IUNO-TDM/MotorShield/MotorShield.brd

## EAGLE design MotorShield.brd (2018-02-16)

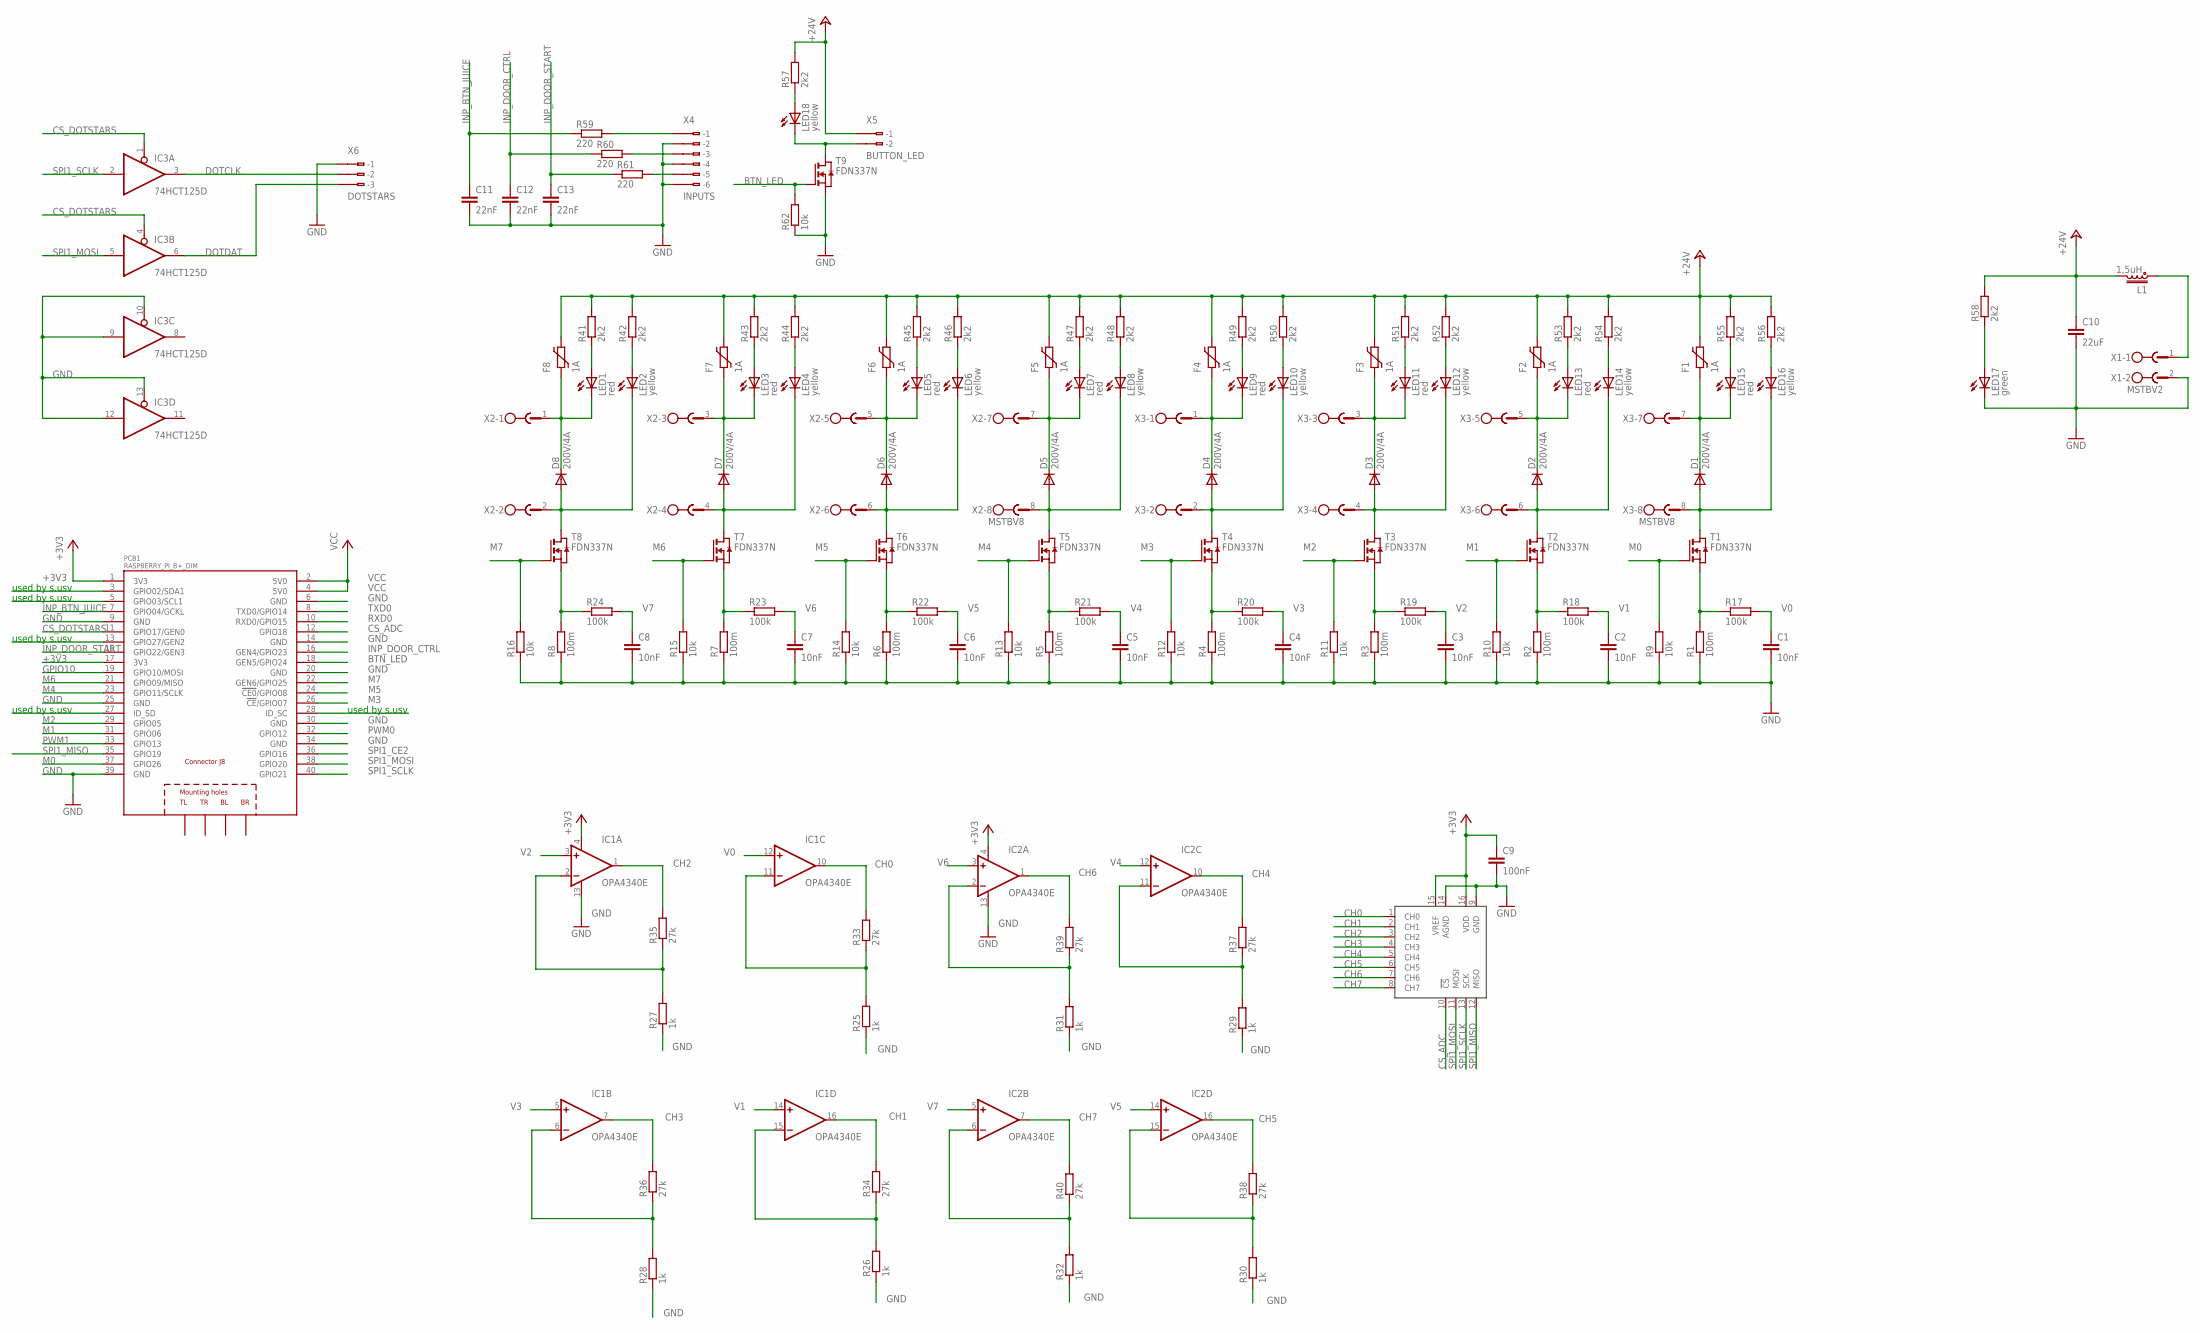
[picture p1: schematic MotorShield.sch]

Parts:
C1, C2, C3, C4, C5, C6, C7, C8: 10nF; C0805
C9: 100nF; C0805
C10: 22uF; C1812
C11, C12, C13: 22nF; C0805K
D1, D2, D3, D4, D5, D6, D7, D8: 200V/4A; DO214AA
F1, F2, F3, F4, F5, F6, F7, F8: 1A; 1812L
IC1, IC2: OPA4340E; SSOP16BU
IC3: 74HCT125D; SO14
IC4: MCP3008SL; SO16
L1: 1,5uH; MPI4040
LED1, LED3, LED5, LED7, LED9, LED11, LED13, LED15: red; CHIP-LED0805
LED2, LED4, LED6, LED8, LED10, LED12, LED14, LED16, LED18: yellow; CHIP-LED0805
LED17: green; CHIP-LED0805
PCB1: RASPBERRY_PI_B+_DIM; RASPBERRY_PI_BPLUS_DIM
R1, R2, R3, R4, R5, R6, R7, R8: 100m; R0805
R9, R10, R11, R12, R13, R14, R15, R16, R62: 10k; R0805
R17, R18, R19, R20, R21, R22, R23, R24: 100k; R0805
R25, R26, R27, R28, R29, R30, R31, R32: 1k; R0805
R33, R34, R35, R36, R37, R38, R39, R40: 27k; R0805
R41, R42, R43, R44, R45, R46, R47, R48, R49, R50, R51, R52, R53, R54, R55, R56, R57, R58: 2k2; R0805
R59, R60, R61: 220; R0805
T1, T2, T3, T4, T5, T6, T7, T8, T9: FDN337N; SOT-23
X1: MSTBV2
X2, X3: MSTBV8
X4: INPUTS; 233-506
X5: BUTTON_LED; 233-502
X6: DOTSTARS; 233-503

Connections:
+3V3: C9.1, IC1.4 (V+), IC2.4 (V+), IC4.15 (VREF), IC4.16 (VDD), PCB1.1 (3V3), PCB1.17 (3V3)
+24V: C10.1, F1.2, F2.2, F3.2, F4.2, F5.2, F6.2, F7.2, F8.2, L1.2, R41.2, R42.2, R43.2, R44.2, R45.2, R46.2, R47.2, R48.2, R49.2, R50.2, R51.2, R52.2, R53.2, R54.2, R55.2, R56.2, R57.2, R58.2, X5.B1 (B-1)
BTN_LED: PCB1.18 (GEN5/GPIO24), R62.2, T9.3 (G)
CH0: IC1.10 (OUT), IC4.1 (CH0), R33.2
CH1: IC1.16 (OUT), IC4.2 (CH1), R34.2
CH2: IC1.1 (OUT), IC4.3 (CH2), R35.2
CH3: IC1.7 (OUT), IC4.4 (CH3), R36.2
CH4: IC2.10 (OUT), IC4.5 (CH4), R37.2
CH5: IC2.16 (OUT), IC4.6 (CH5), R38.2
CH6: IC2.1 (OUT), IC4.7 (CH6), R39.2
CH7: IC2.7 (OUT), IC4.8 (CH7), R40.2
CS_ADC: IC4.10 (!CS), PCB1.12 (GPIO18)
CS_DOTSTARS: IC3.1 (OE), IC3.4 (OE), PCB1.11 (GPIO17/GEN0)
D8: D8.C, F8.1, LED1.C, X2.1
DOTCLK: IC3.3 (O), X6.B2 (B-2)
DOTDAT: IC3.6 (O), X6.B3 (B-3)
GND: C1.2, C2.2, C3.2, C4.2, C5.2, C6.2, C7.2, C8.2, C9.2, C10.2, C11.2, C12.2, C13.2, IC1.13 (V-), IC2.13 (V-), IC3.7 (GND), IC3.9 (I), IC3.10 (OE), IC3.12 (I), IC3.13 (OE), IC4.9 (GND), IC4.14 (AGND), LED17.C, PCB1.6 (GND), PCB1.9 (GND), PCB1.14 (GND), PCB1.20 (GND), PCB1.25 (GND), PCB1.30 (GND), PCB1.34 (GND), PCB1.39 (GND), R1.1, R2.1, R3.1, R4.1, R5.1, R6.1, R7.1, R8.1, R9.1, R10.1, R11.1, R12.1, R13.1, R14.1, R15.1, R16.1, R25.1, R26.1, R27.1, R28.1, R29.1, R30.1, R31.1, R32.1, R62.1, T9.2 (S), X1.2, X4.B2 (B-2), X4.B4 (B-4), X4.B6 (B-6), X6.B1 (B-1)
GPIO10: PCB1.19 (GPIO10/MOSI)
GPIO27: PCB1.13 (GPIO27/GEN2)
INP_BTN_JUICE: C11.1, PCB1.7 (GPIO04/GCKL), R59.1
INP_DOOR_CTRL: C12.1, PCB1.16 (GEN4/GPIO23), R60.1
INP_DOOR_START: C13.1, PCB1.15 (GPIO22/GEN3), R61.1
M0: PCB1.37 (GPIO26), R9.2, T1.3 (G)
M1: PCB1.31 (GPIO06), R10.2, T2.3 (G)
M2: PCB1.29 (GPIO05), R11.2, T3.3 (G)
M3: PCB1.26 (!CE!/GPIO07), R12.2, T4.3 (G)
M4: PCB1.23 (GPIO11/SCLK), R13.2, T5.3 (G)
M5: PCB1.24 (!CE0!/GPIO08), R14.2, T6.3 (G)
M6: PCB1.21 (GPIO09/MISO), R15.2, T7.3 (G)
M7: PCB1.22 (GEN6/GPIO25), R16.2, T8.3 (G)
unnamed: D8.A, LED2.C, T8.1 (D), X2.2
unnamed: R8.2, R24.1, T8.2 (S)
unnamed: D1.C, F1.1, LED15.C, X3.7
unnamed: D2.C, F2.1, LED13.C, X3.5
unnamed: IC1.2 (-IN), R27.2, R35.1
unnamed: D3.C, F3.1, LED11.C, X3.3
unnamed: D4.C, F4.1, LED9.C, X3.1
unnamed: D5.C, F5.1, LED7.C, X2.7
unnamed: D7.A, LED4.C, T7.1 (D), X2.4
unnamed: R7.2, R23.1, T7.2 (S)
unnamed: D6.C, F6.1, LED5.C, X2.5
unnamed: D7.C, F7.1, LED3.C, X2.3
unnamed: IC1.6 (-IN), R28.2, R36.1
unnamed: D6.A, LED6.C, T6.1 (D), X2.6
unnamed: R6.2, R22.1, T6.2 (S)
unnamed: IC1.11 (-IN), R25.2, R33.1
unnamed: L1.1, X1.1
unnamed: LED15.A, R55.1
unnamed: LED16.A, R56.1
unnamed: D5.A, LED8.C, T5.1 (D), X2.8
unnamed: IC1.15 (-IN), R26.2, R34.1
unnamed: LED1.A, R41.1
unnamed: R5.2, R21.1, T5.2 (S)
unnamed: LED2.A, R42.1
unnamed: IC2.2 (-IN), R31.2, R39.1
unnamed: LED18.C, T9.1 (D), X5.B2 (B-2)
unnamed: R59.2, X4.B1 (B-1)
unnamed: IC2.6 (-IN), R32.2, R40.1
unnamed: LED3.A, R43.1
unnamed: LED4.A, R44.1
unnamed: IC2.11 (-IN), R29.2, R37.1
unnamed: D4.A, LED10.C, T4.1 (D), X3.2
unnamed: R4.2, R20.1, T4.2 (S)
unnamed: IC2.15 (-IN), R30.2, R38.1
unnamed: LED6.A, R46.1
unnamed: LED5.A, R45.1
unnamed: LED7.A, R47.1
unnamed: LED8.A, R48.1
unnamed: D3.A, LED12.C, T3.1 (D), X3.4
unnamed: R3.2, R19.1, T3.2 (S)
unnamed: LED9.A, R49.1
unnamed: LED10.A, R50.1
unnamed: LED11.A, R51.1
unnamed: LED12.A, R52.1
unnamed: D2.A, LED14.C, T2.1 (D), X3.6
unnamed: R2.2, R18.1, T2.2 (S)
unnamed: LED13.A, R53.1
unnamed: LED14.A, R54.1
unnamed: D1.A, LED16.C, T1.1 (D), X3.8
unnamed: R1.2, R17.1, T1.2 (S)
unnamed: R60.2, X4.B3 (B-3)
unnamed: R61.2, X4.B5 (B-5)
unnamed: LED17.A, R58.1
unnamed: LED18.A, R57.1
PWM0: PCB1.32 (GPIO12)
PWM1: PCB1.33 (GPIO13)
RXD0: PCB1.10 (RXD0/GPIO15)
SPI1_CE2: PCB1.36 (GPIO16)
SPI1_MISO: IC4.12 (MISO), PCB1.35 (GPIO19)
SPI1_MOSI: IC3.5 (I), IC4.11 (MOSI), PCB1.38 (GPIO20)
SPI1_SCLK: IC3.2 (I), IC4.13 (SCK), PCB1.40 (GPIO21)
TXD0: PCB1.8 (TXD0/GPIO14)
V0: C1.1, IC1.12 (+IN), R17.2
V1: C2.1, IC1.14 (+IN), R18.2
V2: C3.1, IC1.3 (+IN), R19.2
V3: C4.1, IC1.5 (+IN), R20.2
V4: C5.1, IC2.12 (+IN), R21.2
V5: C6.1, IC2.14 (+IN), R22.2
V6: C7.1, IC2.3 (+IN), R23.2
V7: C8.1, IC2.5 (+IN), R24.2
VCC: IC3.14 (VCC), PCB1.2 (5V0), PCB1.4 (5V0)

Notes on the sheet:
used by s.usv

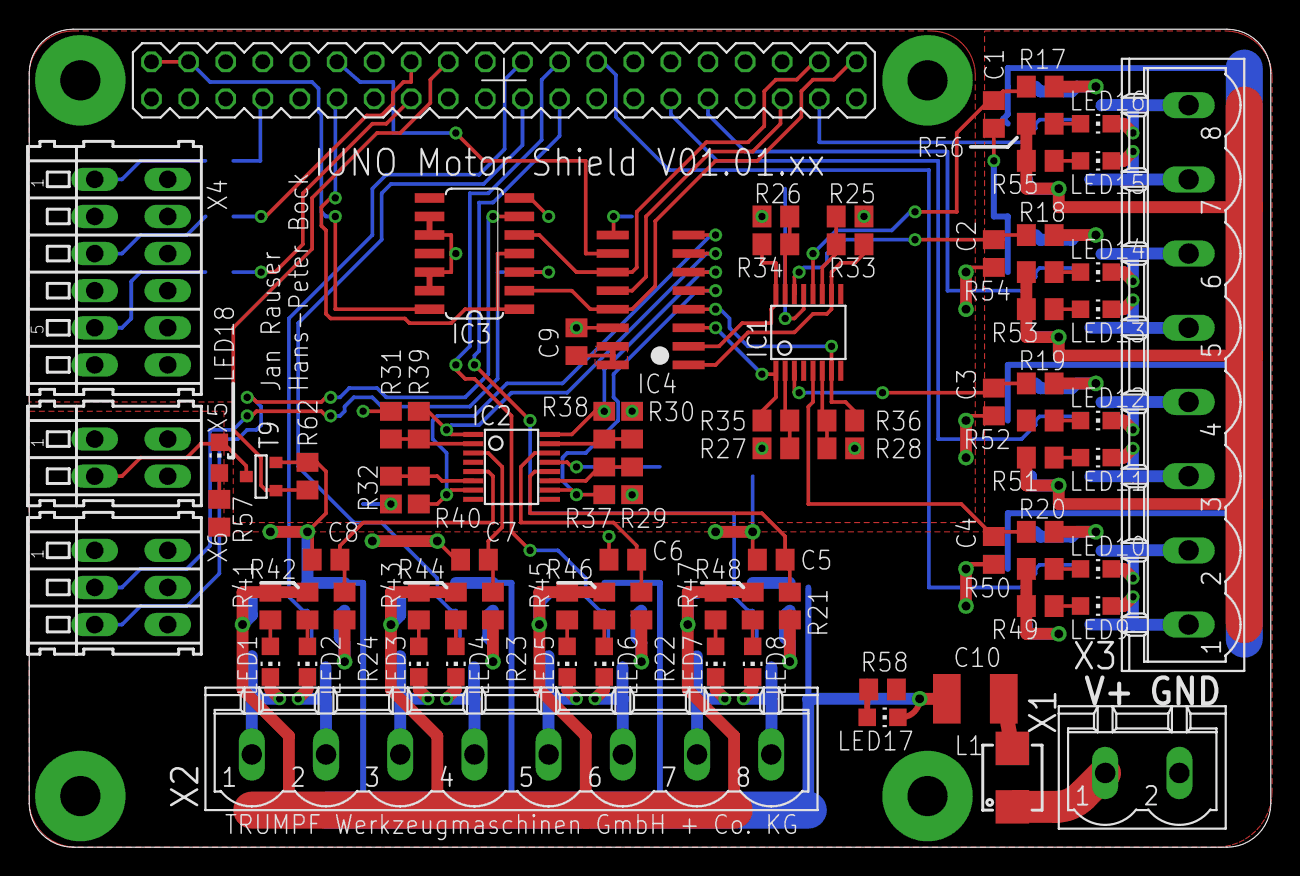
[picture p2: board MotorShield.brd from above]

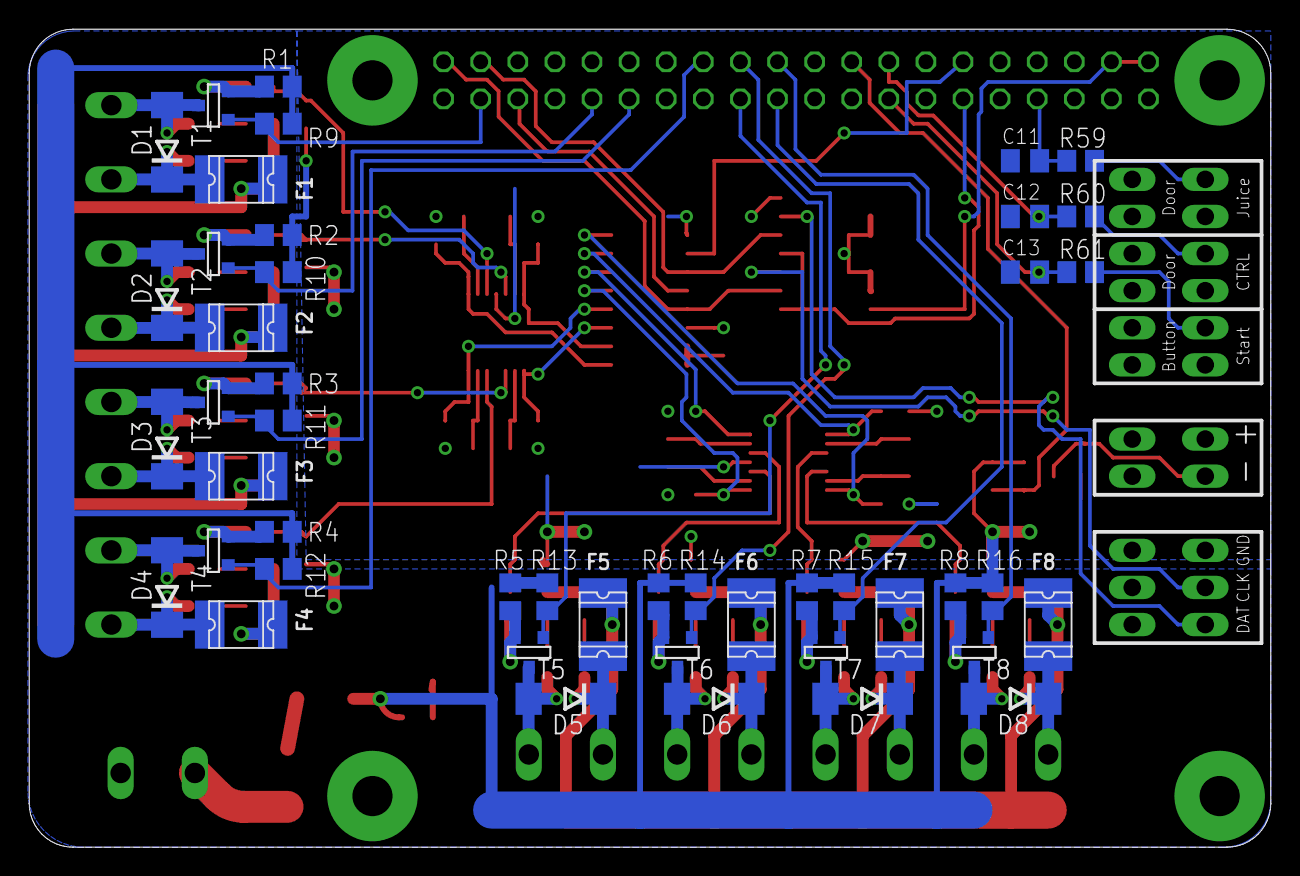
[picture p3: board MotorShield.brd from below]

Board: 2 copper layers, 85.0 x 56.0 mm, 130 parts (46 on the bottom side), 94 nets.
