IUNO-TDM/MotorShield/(threads)

Thread 1 (2017-08-03):

Vias der AKL Buchsen zu klein

JanR2311, 2017-08-03:
Die Breite der Pins der AKL-Buchsen sind Reckteckig und haben die Maße 0,8x0,8 mm.
Vias sind kreisförmig und haben einen Durchmesser von 0,9mm.

--> Größe der Vias müssen auf einen Mindestdurchmesser von 1,6mm vergrößert werden.

bockha, 2017-09-05:
Die Durchmesser der Pads sind nun zu groß.

Closed 2017-09-05.

Thread 2 (2017-08-03):

MISO MOSI Anschlüsse vertauscht.

JanR2311, 2017-08-03:
Die Anschlüsse MISO und MOSI für die SPI-Verbindung zwischen dem ADC (MCP3008) und dem Raspberry Pi sind vertauscht.
Der output Pin Din des ADC ist mit MISO verbunden.
Der input Pin Dout mit MOSI.

--> Din mit MOSI verbinden.
-->Dout mit MISO verbinden.

Closed 2017-09-05.

Thread 3 (2017-08-07):

optionally add level shifter for dotstar leds

bockha, 2017-08-07:
Optionally add a level shifter according to the [Adafruit Dotstar Painter](https://learn.adafruit.com/dotstar-pi-painter?view=all) to the shield.
Connect the **!OE** pins to **!CE1** instead to GND.
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

bockha, 2017-11-20:
```
1A  - GPIO 10 - PIN 19
2A  - GPIO 11 - PIN 23
1OE - GPIO 7  - PIN 26
2OE - GPIO 7  - PIN 26
```
http://raspberrypi.ws/

Closed 2017-12-01.

Thread 5 (2017-08-11):

change power input

bockha, 2017-08-11:
Change the power input to a [barrel connector](https://www.conrad.de/de/niedervolt-steckverbinder-buchse-einbau-horizontal-55-mm-25-mm-bkl-electronic-075823-1-st-738120.html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) to which a power supply unit like [MW 2108GS/F2USB](https://www.reichelt.de/Netzteile-fuer-Note-Netbooks-PDAs/MW-2108GS-F2USB/3/index.html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) can easily be connected. Consider that the barrel connector is suitable for the expected maximum current.

bockha, 2017-12-01:
[233-202 -  Wire-To-Board-Reihenklemme, 2.5 mm, 2 -polig, 28 AWG, 20 AWG, 0.5 mm², Steckanschluss](http://de.farnell.com/wago/233-202/anschlussblock-pcb-2polig/dp/1283532?ost=233-202) is now used in 6c05bb3efd8f283ea9fdacd92118646fb16388f7

Closed 2017-12-01.

Thread 7 (2017-08-14):

add connectors for switches and buttons

bockha, 2017-08-14:
add connector for at least three input switches:
* push button to start production
* switch for juice door
* switch for control door

bockha, 2017-12-01:
[233-206 -  Wire-To-Board-Reihenklemme](http://de.farnell.com/wago/233-206/anschlussblock-pcb-6polig/dp/1283536?ost=233-206)

Closed 2017-12-01.

Thread 8 (2017-08-18):

screw hole for spacers seem to not fit correctly

bockha, 2017-08-18:
move the screw holes for the spacers so that they fit the raspberry pi 3 layout

bockha, 2017-08-29:
The screws looked skewed because they were not tightened. The screw holes are placed correctly.

Closed 2017-08-29.

Thread 9 (2017-08-18):

add reset button

bockha, 2017-08-18:
add a [reset button](https://www.raspberrypi.org/forums/viewtopic.php?f=91&t=147361) for the raspberry pi to the layout

bockha, 2017-12-07:
The position of the run switch is different for different versions of raspberry pi.

Closed 2017-12-07.

Thread 10 (2017-09-26):

establish compatibility with s.usv

bockha, 2017-09-26:
Establish compatibility with the [s.usv Pi](https://www.s-usv.de/susv_pibasic.html) hat that uses some GPIOs that the MotorShield uses.

# pins used by s.usv
Pin | Name | Usage | MotorShield
----|--------|--------|---------------
Pin 02 | DC Power +5V | Stromversorgung | n/a
Pin 03 | GPIO 02 (SDA1, I²C) | I²C Datenleitung | n/a
Pin 05 | GPIO 03 (SCL1, I²C) | I²C Taktleitung | n/a
Pin 13 | GPIO 27 (GPIO_GEN2) | Zustandsüberwachung S.USV | **used for M5**
Pin 27 | ID_SD (I²C ID EEPROM) | ID Datenleitung | n/a
Pin 28 | ID_SC (I²C ID EEPROM) | ID Taktleitung | n/a

Closed 2017-12-01.

Thread 11 (2017-09-26):

modify dotstar library to use correct CS

bockha, 2017-09-26:
Modify the _dotstar.so_ to use spi0.1 with chip select according to #3.

bockha, 2017-11-20:
dotstar.c
```
@@ -257,11 +257,11 @@ static int boardType(void) {
 // Initialize pins/SPI for output
 static PyObject *begin(DotStarObject *self) {
        if(self->dataPin == 0xFF) { // Use hardware SPI
-               if((self->fd = open("/dev/spidev0.0", O_RDWR)) < 0) {
-                       printf("Can't open /dev/spidev0.0 (try 'sudo')\n");
+               if((self->fd = open("/dev/spidev0.1", O_RDWR)) < 0) {
+                       printf("Can't open /dev/spidev0.1 (try 'sudo')\n");
                        return NULL;
                }
-               uint8_t mode = SPI_MODE_0 | SPI_NO_CS;
+               uint8_t mode = SPI_MODE_0 ; // | SPI_NO_CS;
                ioctl(self->fd, SPI_IOC_WR_MODE, &mode);
                // The actual data rate may be less than requested.
                // Hardware SPI speed is a function of the system core

```

bockha, 2017-11-23:
This issue was moved to IUNO-TDM/MixerControl#101

bockha, 2017-12-13:
SPI1 with CE1 is used in future revision of motorshield

bockha, 2018-01-12:
This issue was moved to IUNO-TDM/MixerControl#116

Closed 2018-01-12.

Thread 12 (2017-09-26):

AKL connectors off grid in schematic

hpbock, 2017-09-26:
the AKL connectors are designed out of grid and can not be connected to a net. The connectors could be changed to use PxC MSTB connectors. These footprints are already contained in the eagle libraries.

bockha, 2017-12-01:
[1757242 -  Reihenklemme, Stiftleiste, 5.08 mm, 2 -polig, 12 A, 250 V, Durchsteckmontage, abgewinkelt ](http://de.farnell.com/phoenix-contact/1757242/stiftleiste-90gr-5-08mm-2pol/dp/3705171?ost=3705171)

Closed 2017-12-01.

Thread 14 (2017-10-04):

add input for start button

bockha, 2017-10-04:
add input for a start button IUNO-TDM/MixerFrame#3
add output with open collector for driving the illumination of a button up to 24V

bockha, 2017-12-01:
duplicate of #7

Closed 2017-12-01.

Thread 16 (2017-12-07):

add author notice and logos to silkscreen

bockha, 2017-12-07:
Add author notices and logos to silkscreen:
- [x] Jan Rauser
- [x] Hans-Peter Bock
- [x] TRUMPF Werkzeugmaschinen GmbH + Co. KG
- [ ] [Open Hardware](http://www.baconfatlabs.com/2011/11/oshw-eagle-symbols-for-schematic-and-silkscreen/)
- [ ] [Creative Commons](http://www.stephanharms.de/CreativeCommons-EAGLE-lib)

bockha, 2017-12-19:
won't fix for CC and OH

Closed 2017-12-19.

Thread 18 (2018-01-09):

wago connector not available

bockha, 2018-01-09:
The Wago 233-202 is not available at the distributor.

All WAGO clamps shall be exchanged from 233-20x to 233-50x since these are available and fit better to the pcbs grid.

Closed 2018-01-09.

Thread 19 (2018-01-16):

spi1 on raspberry pi seems to be broken

bockha, 2018-01-16:
It seems to be impossible to drive dotstar LEDs using spidev1.1 on raspberry pi. Maybe because [dma seems not to be supported by raspberry pi on spi1](https://www.raspberrypi.org/forums/viewtopic.php?t=191301#p1201017). All changes shall be rolled back to use spidev0.1:

* [ ] Motorshield layout and wiring
* [ ] [Adafruit DotStar Pi](https://github.com/IUNO-TDM/Adafruit_DotStar_Pi) library in IUNO organisation
* [ ] [Pumpcontrol](https://github.com/IUNO-TDM/PumpControl)

bockha, 2018-01-26:
By not using the Adafruit DotStar library any longer, this is no more an issue. See IUNO-TDM/MixerControl#122 for details.

Closed 2018-01-26.

Thread 25 (2018-03-02):

mosfet trips quicker than fuse

bockha, 2018-03-02:
With a real shortcut at the motor connector, the mosfet trips quicker (always on) than the polyfuse.

bockha, 2018-03-15:
Maybe IRFR5305 could help, see [schematic of BL-Ctrl V1.2](http://wiki.mikrokopter.de/BL-Ctrl_V1.2). Take into account that the IRFR5303 has a maximum Vgs of 20V!
