IUNO-TDM/MotorShield/(commit log)

2017-09-05 corrected MISO and MOSI closes #2
    [MotorBoardPrototyp4_polyfuse.brd, MotorBoardPrototyp4_polyfuse.sch]
2017-09-05 removed ptc fuse versions
    [MotorBoardPrototyp4_ptcfuse.brd, MotorBoardPrototyp4_ptcfuse.sch]
2017-09-05 corrected diameter of pads closes #1
    [MotorBoardPrototyp4_polyfuse.brd, MotorBoardPrototyp4_polyfuse.sch]
2017-09-05 corrected diameter for pads closes #1
    [MotorBoardPrototyp4_polyfuse.brd, MotorBoardPrototyp4_polyfuse.sch]
2017-09-05 added partlist
    [partlist.xlsx]
2017-09-05 converted file format back to eagle version 6.6.0
    [MotorBoardPrototyp4_polyfuse.brd, MotorBoardPrototyp4_polyfuse.sch]
2017-09-05 renamed files
    [MotorShield.brd, MotorShield.sch]
2017-10-09 marked gpios that are used by s.usv basic, see #10
    [MotorShield.brd, MotorShield.sch]
2017-10-09 added 74HCT125D for DotStar pixels, see #3
    [MotorShield.brd, MotorShield.sch]
2017-12-01 added label to power input closes #15
    [MotorShield.brd]
2017-12-01 pump no. 5 is now controlled by GPIO23 fixes #10
    [MotorShield.brd, MotorShield.sch]
2017-12-01 changed connectors fixes #12
    [MotorShield.brd, MotorShield.sch]
2017-12-01 added connectors for inputs, button LED and dotstars fixes #7
    [MotorShield.brd, MotorShield.sch]
2017-12-01 changed fuse library to ptc-litlefuse from https://github.com/halfakop/eagle-lbr
    [MotorShield.brd, MotorShield.sch]
2017-12-01 added LEDs to indicate powered outputs and tripped fuses fixes #4, fixes #6
    [MotorShield.brd, MotorShield.sch]
2017-12-01 exchanged MCP3008 symbol and footprint https://github.com/hpbock/PCB-Designs/blob/master/!Libraries/MCP3008.lbr
    [MotorShield.brd, MotorShield.sch]
2017-12-01 added net classes and tried to place components for M1
    [MotorShield.brd, MotorShield.sch]
2017-12-07 assigned values to protective resistors
    [MotorShield.brd, MotorShield.sch]
2017-12-07 routed devices for M4 and M3
    [MotorShield.brd, MotorShield.sch]
2017-12-07 routed M1 to M4
    [MotorShield.brd, MotorShield.sch]
2017-12-07 placed parts for M5-M6
    [MotorShield.brd, MotorShield.sch]
2017-12-10 routed op-amps
    [MotorShield.brd, MotorShield.sch]
2017-12-12 more routing
    [MotorShield.brd]
2017-12-13 completely changed wiring of GPIOs https://github.com/IUNO-TDM/PumpControl/issues/27 https://github.com/IUNO-TDM/MotorShield/issues/11
    [MotorShield.brd, MotorShield.sch]
2017-12-18 added power indicator led
    [MotorShield.brd, MotorShield.sch]
2017-12-18 finished routing, no more airwires :)
    [MotorShield.brd, MotorShield.sch]
2017-12-18 shrunk most vias
    [MotorShield.brd]
2017-12-19 revised routing
    [MotorShield.brd, MotorShield.sch]
2017-12-19 placed names on top side
    [MotorShield.brd]
2017-12-19 placed names on bottom side
    [MotorShield.brd]
2017-12-22 optimized some routes
    [MotorShield.brd]
2018-01-07 minor changes to pcb
    [MotorShield.brd]
2018-01-08 added name and version number of shield to top silkscreen
    [MotorShield.brd]
2018-01-08 marked version label as development version
    [MotorShield.brd]
2018-01-09 changed wago clamps fixes #18
    [MotorShield.brd, MotorShield.sch, partlist.xlsx]
2018-01-16 moved apart overlapping circuits in schematic
    [MotorShield.sch]
2018-01-16 added button led reordered device names
    [MotorShield.brd, MotorShield.sch]
2018-01-16 version V01.00.01
    [MotorShield.brd]
2018-01-16 marked as developement version
    [MotorShield.brd]
2018-01-22 optimized some wires and names
    [MotorShield.brd]
2018-01-30 fixed some badly misplaced resistor labels
    [MotorShield.brd]
2018-02-05 added markers to layer tName
    [MotorShield.brd]
2018-02-08 Moved input for start button near to X5. #24
    [MotorShield.brd, MotorShield.sch]
2018-02-08 added connector labels to X4 #24
    [MotorShield.brd]
2018-02-08 added connector labels to X5 and X6 fixes #21, fixes #22
    [MotorShield.brd]
2018-02-08 debounced inputs fixes #20
    [MotorShield.brd, MotorShield.sch]
2018-02-09 fixed footprint of L1 fixes #23
    [MotorShield.brd, MotorShield.sch]
2018-02-14 moved C9 to top layer
    [MotorShield.brd]
